Embinha/fechadura-eletronica-rfid/docs/evidencias/02 - Modulo rele SRD-05VDC.jpeg

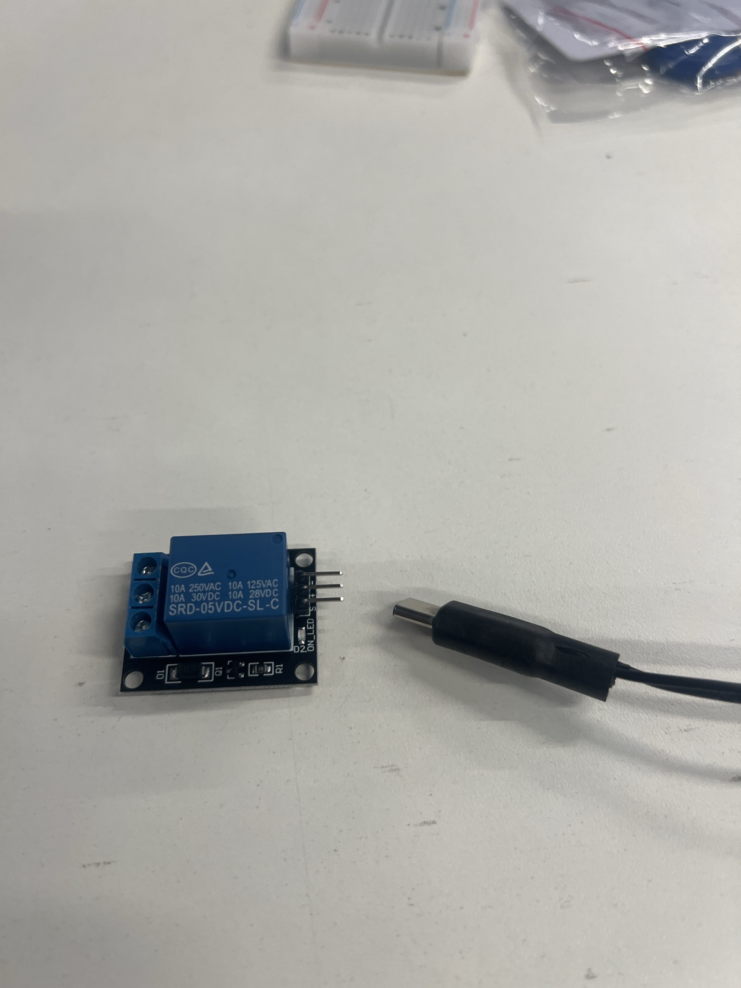
docs/evidencias/02 - Modulo rele SRD-05VDC.jpeg
