Embinha/fechadura-eletronica-rfid/docs/evidencias/03 - Fechadura solenoide.jpg

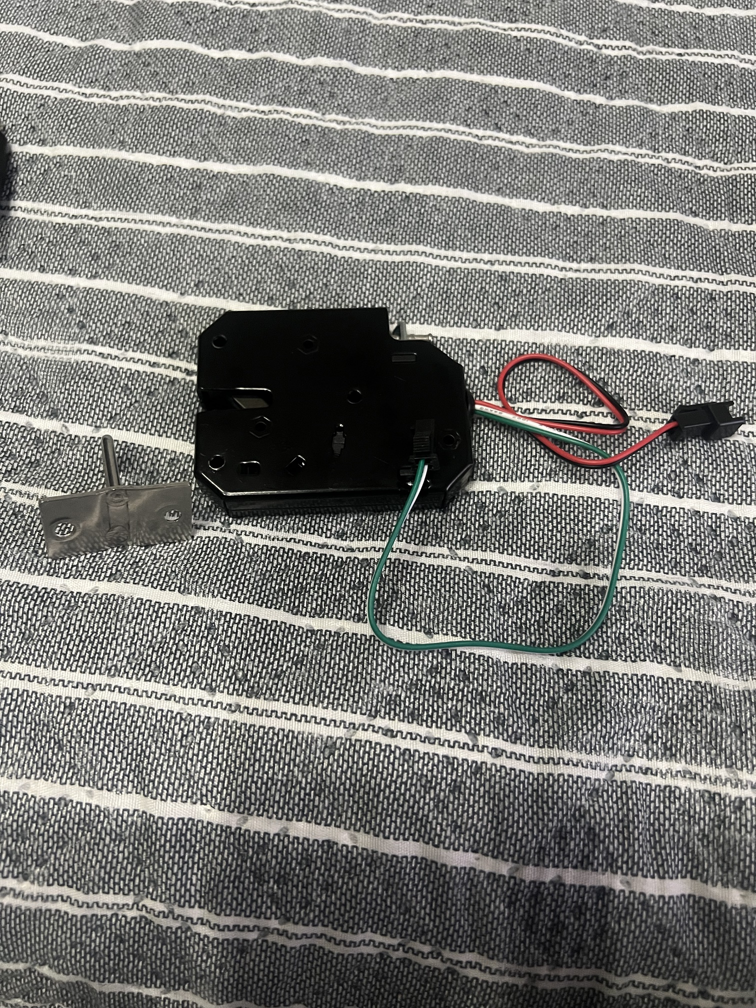
docs/evidencias/03 - Fechadura solenoide.jpg
