Embinha/fechadura-eletronica-rfid/docs/evidencias/04 - Fonte 12V 2A etiqueta.jpg

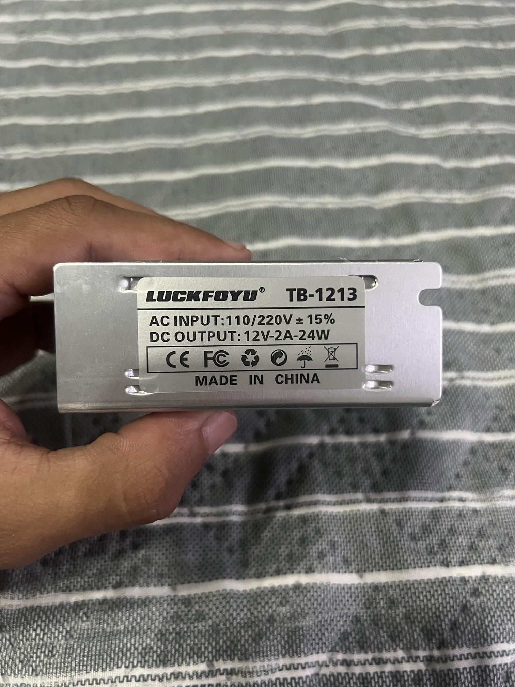
docs/evidencias/04 - Fonte 12V 2A etiqueta.jpg
