Embinha/fechadura-eletronica-rfid/docs/evidencias/05 - Ligacao do RC522 (pinos soldados).jpg

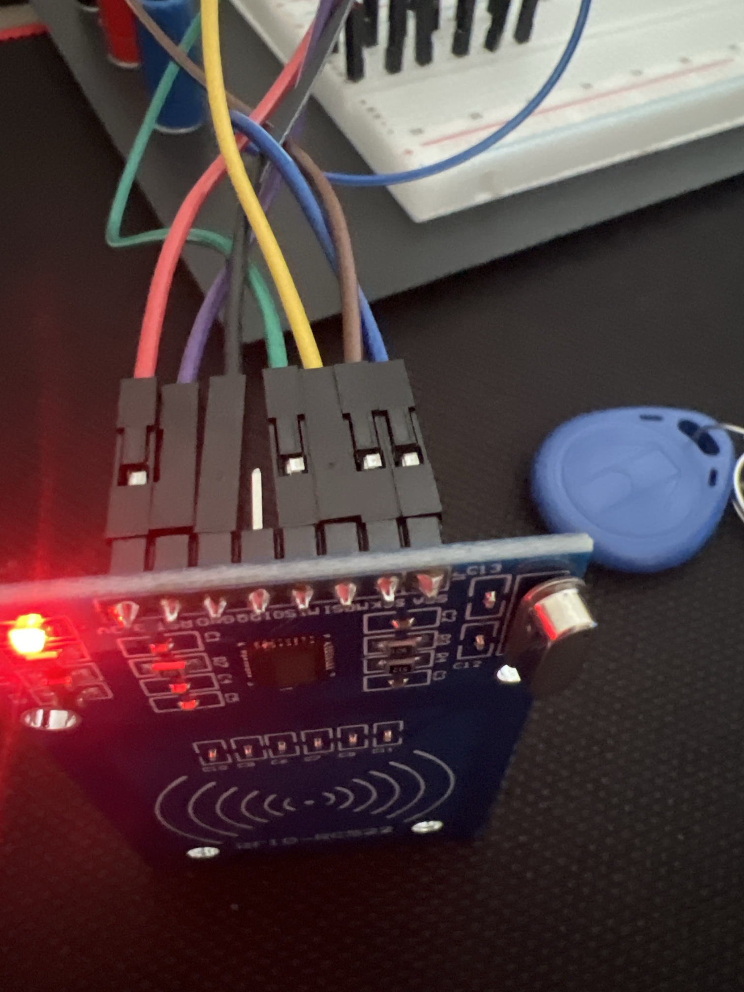
docs/evidencias/05 - Ligacao do RC522 (pinos soldados).jpg
