Embinha/fechadura-eletronica-rfid/docs/evidencias/07 - Upload do codigo no ESP32 concluido.png

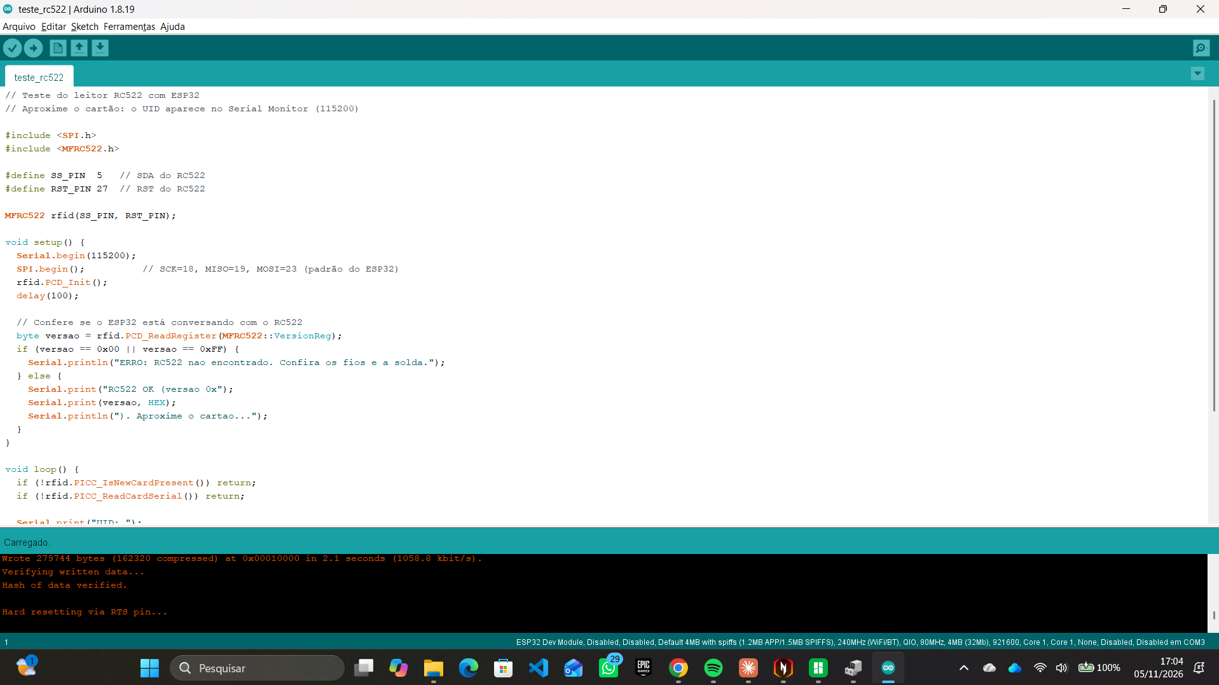
docs/evidencias/07 - Upload do codigo no ESP32 concluido.png
