Embinha/fechadura-eletronica-rfid/docs/evidencias/08 - RC522 comunicando com ESP32 (versao 0x92).png

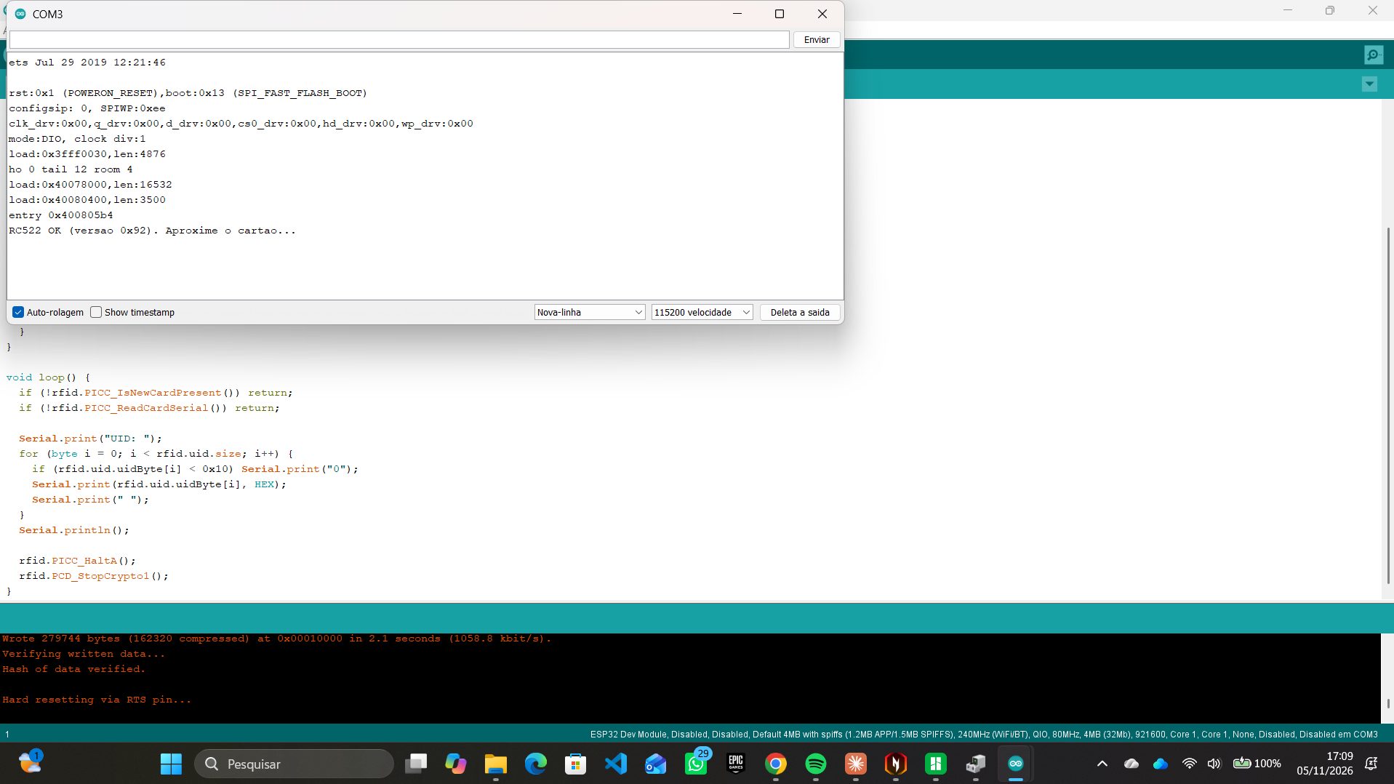
docs/evidencias/08 - RC522 comunicando com ESP32 (versao 0x92).png
