Embinha/fechadura-eletronica-rfid/docs/evidencias/09 - Diagnostico RC522 - autoteste falhou.png

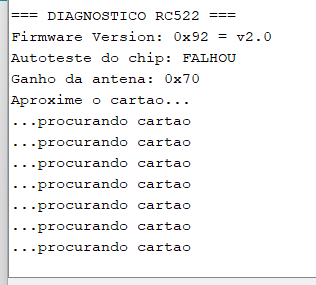
docs/evidencias/09 - Diagnostico RC522 - autoteste falhou.png
