Embinha/fechadura-eletronica-rfid/docs/evidencias/11 - Diagnostico com fio curto - autoteste falhou.png

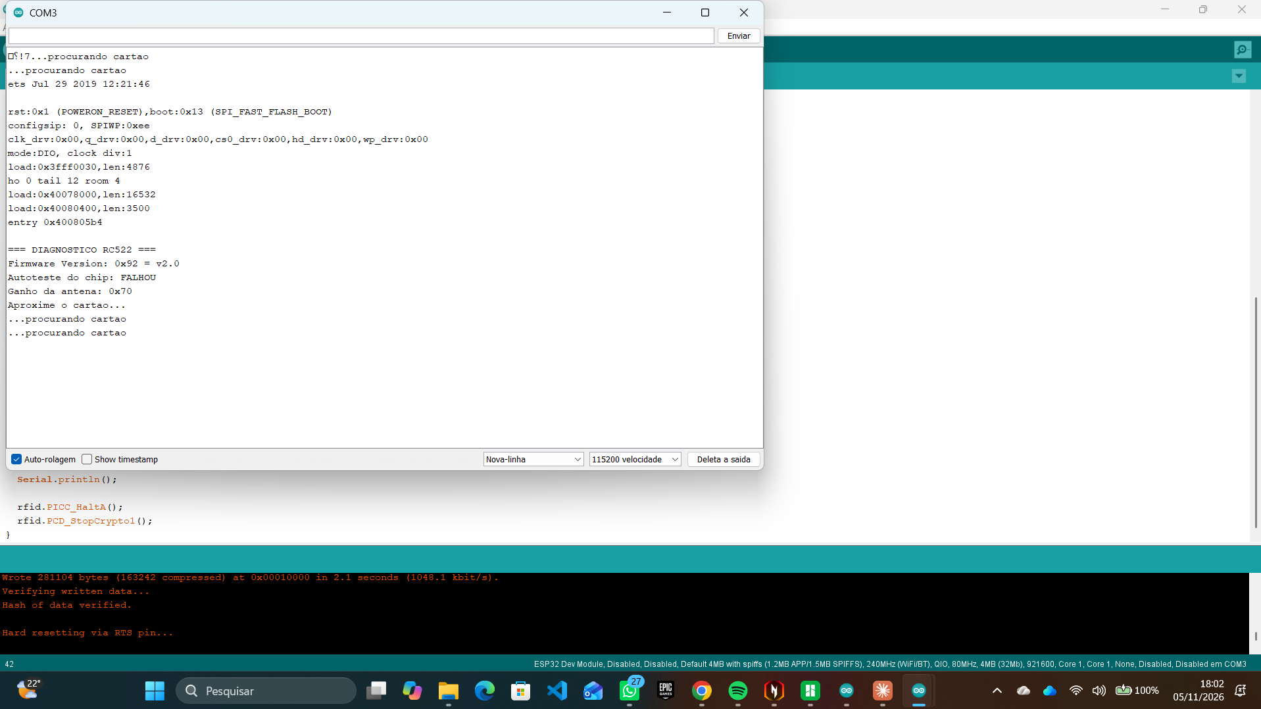
docs/evidencias/11 - Diagnostico com fio curto - autoteste falhou.png
