Embinha/fechadura-eletronica-rfid/docs/evidencias/12 - Cartao detectado mas falha ao ler UID.jpg

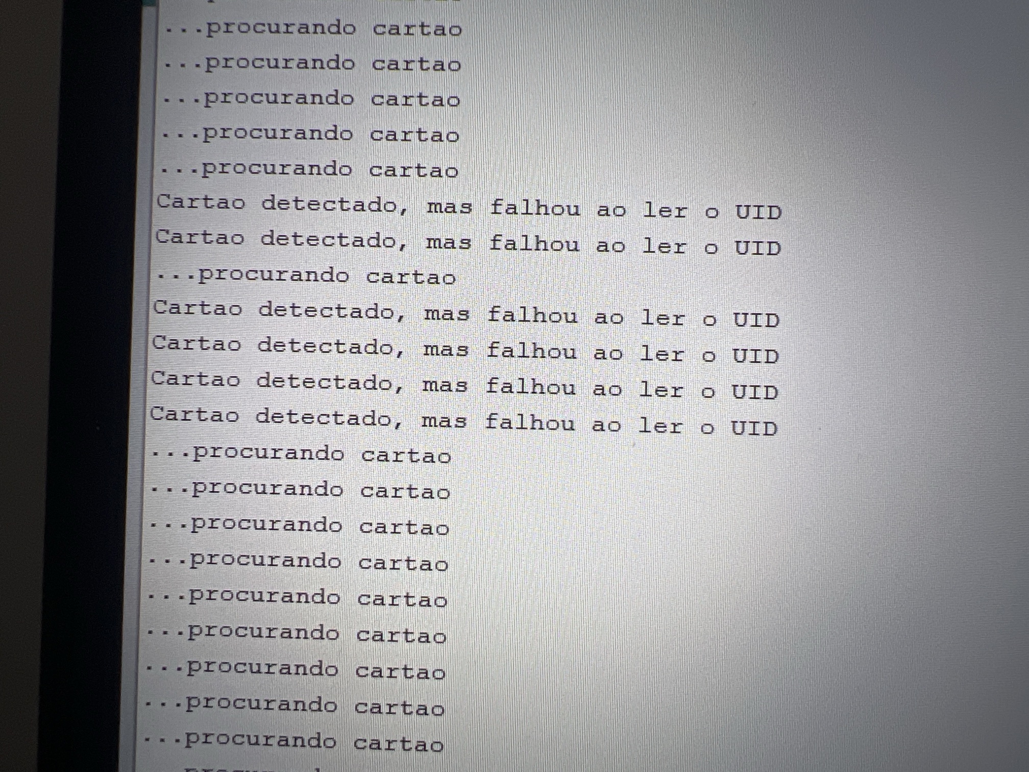
docs/evidencias/12 - Cartao detectado mas falha ao ler UID.jpg
