Embinha/fechadura-eletronica-rfid/docs/evidencias/15 - Abertura remota pelo navegador (log LIBERADO).png

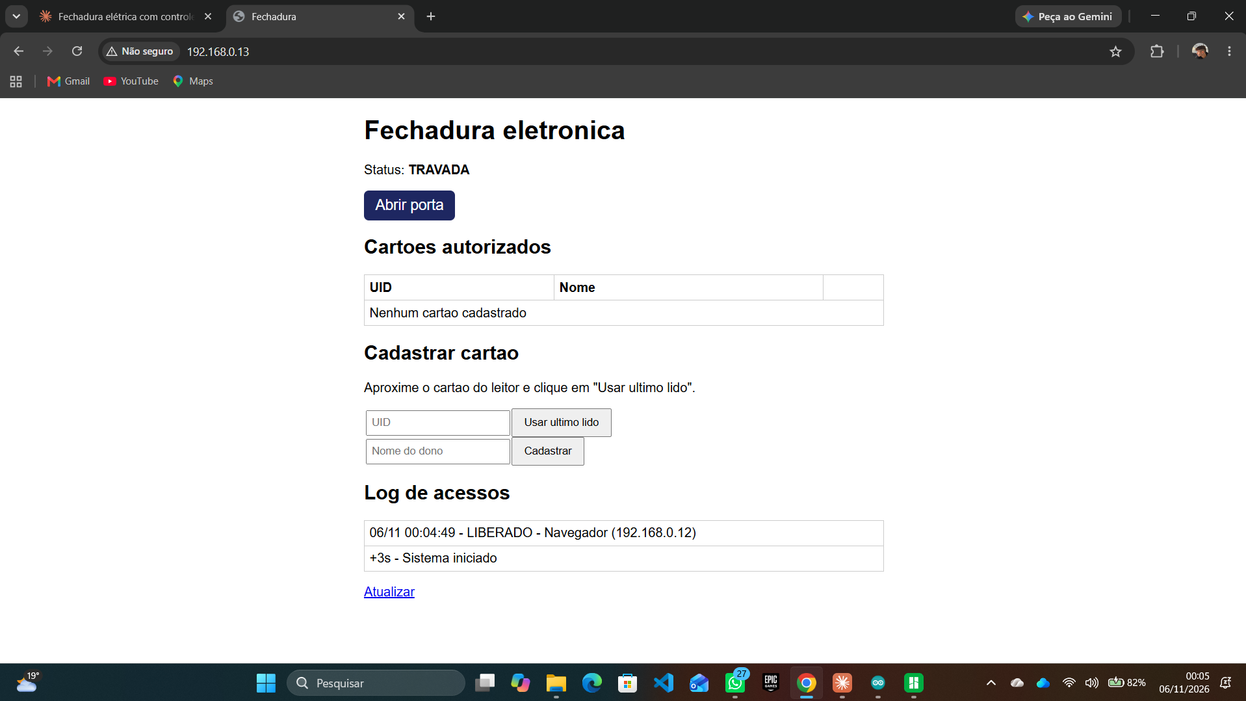
docs/evidencias/15 - Abertura remota pelo navegador (log LIBERADO).png
