Embinha/fechadura-eletronica-rfid/docs/evidencias/17 - Cartao cadastrado e log de acessos.png

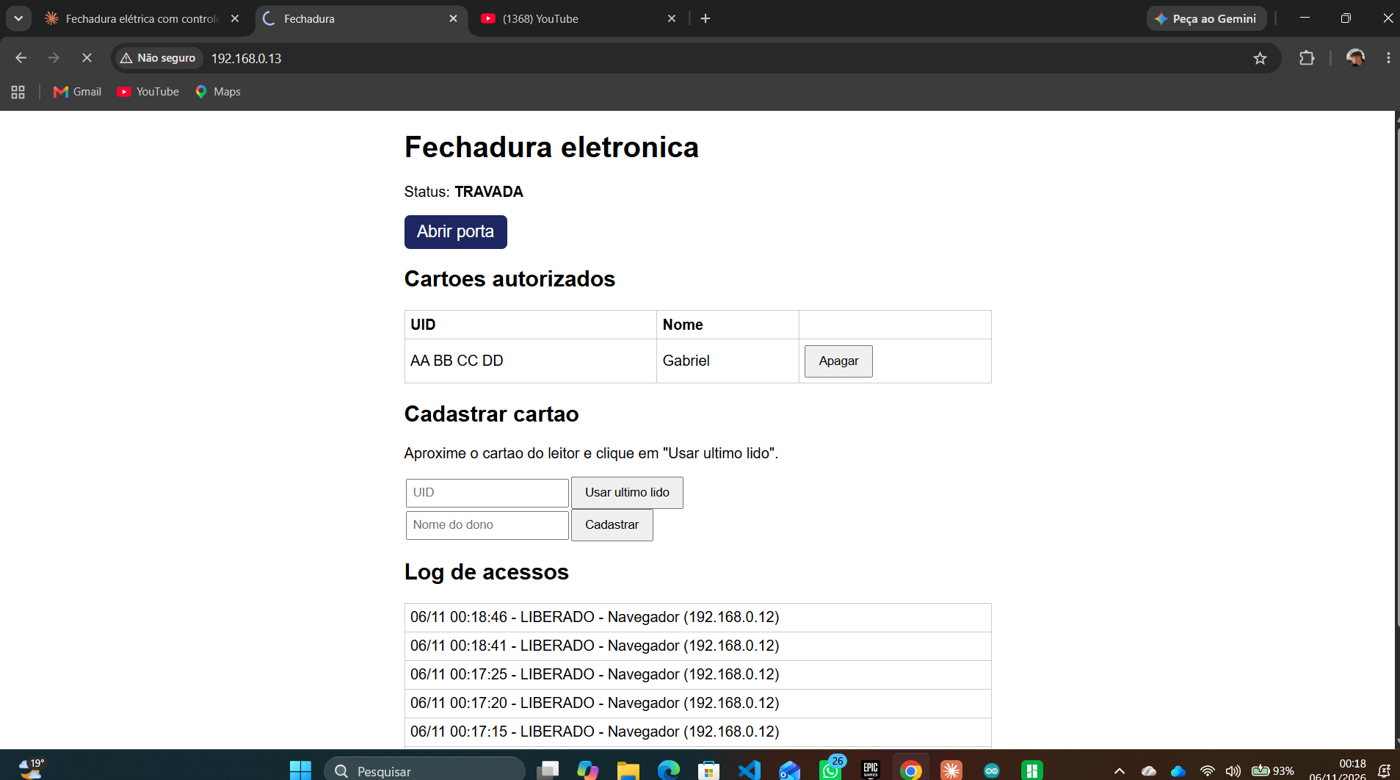
docs/evidencias/17 - Cartao cadastrado e log de acessos.png
