Embinha/fechadura-eletronica-rfid/docs/evidencias/18 - RC522 lendo UID de cartao e chaveiro.png

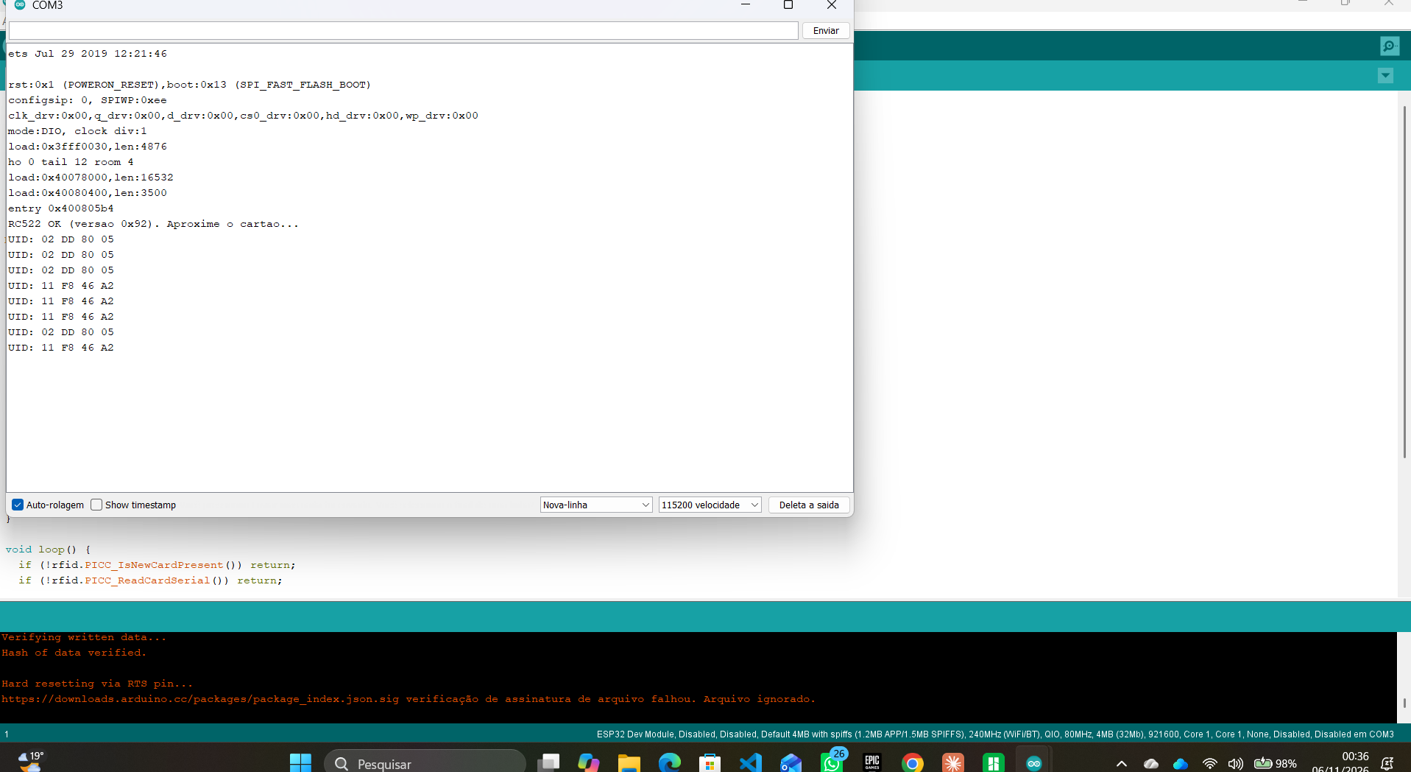
docs/evidencias/18 - RC522 lendo UID de cartao e chaveiro.png
