Embinha/fechadura-eletronica-rfid/docs/evidencias/21 - Log com LOGIN RECUSADO apos senha errada.png

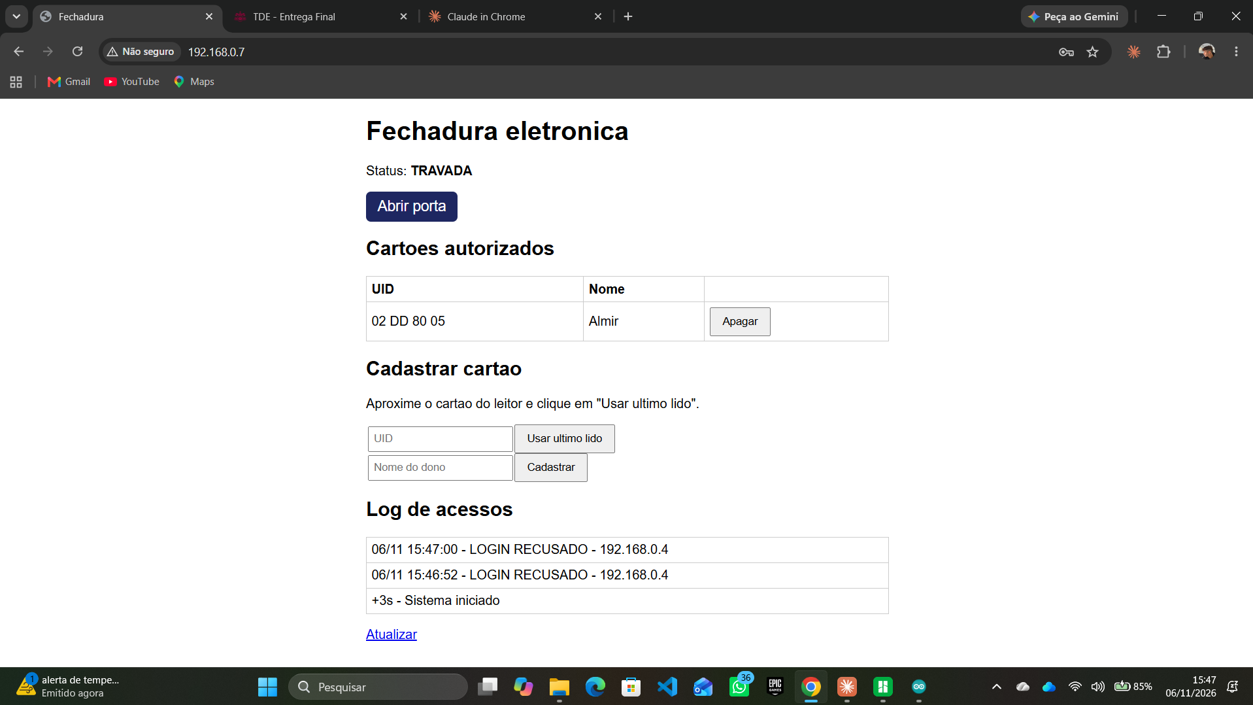
docs/evidencias/21 - Log com LOGIN RECUSADO apos senha errada.png
