Embinha/fechadura-eletronica-rfid/docs/evidencias/23 - Fechadura com o pino travado (sem energia).jpg

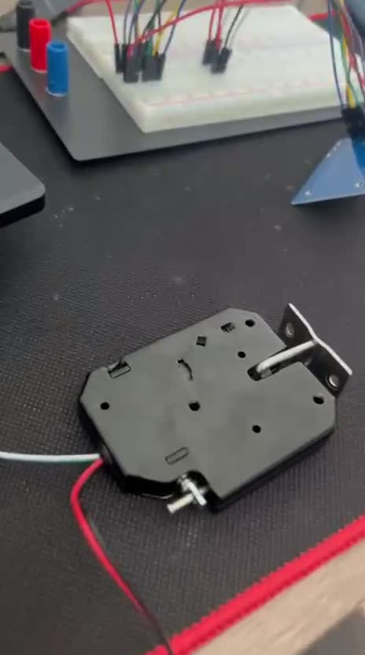
docs/evidencias/23 - Fechadura com o pino travado (sem energia).jpg
