Embinha/fechadura-eletronica-rfid/docs/maquete_3d/render_costas.png

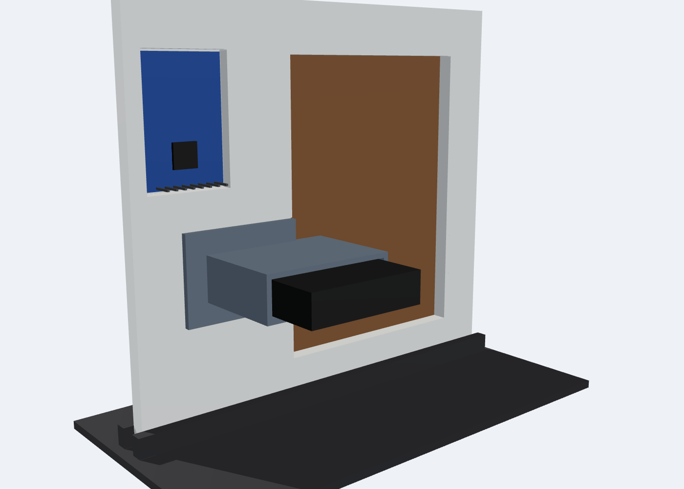
docs/maquete_3d/render_costas.png
