Embinha/fechadura-eletronica-rfid/docs/maquete_3d/render_frente.png

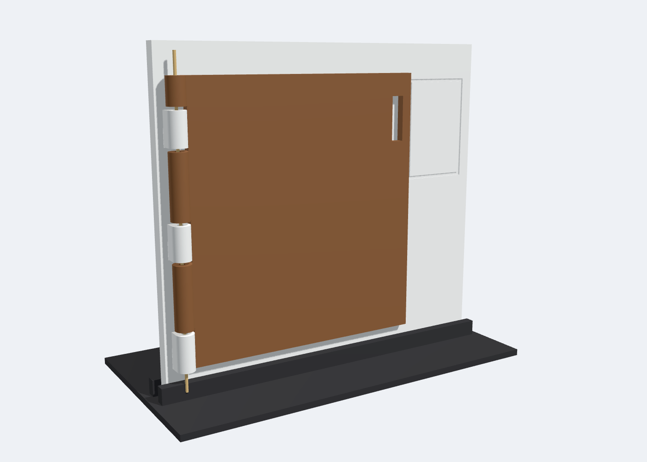
docs/maquete_3d/render_frente.png
