Embinha/fechadura-eletronica-rfid/docs/maquete_3d/4_suporte_fechadura.stl

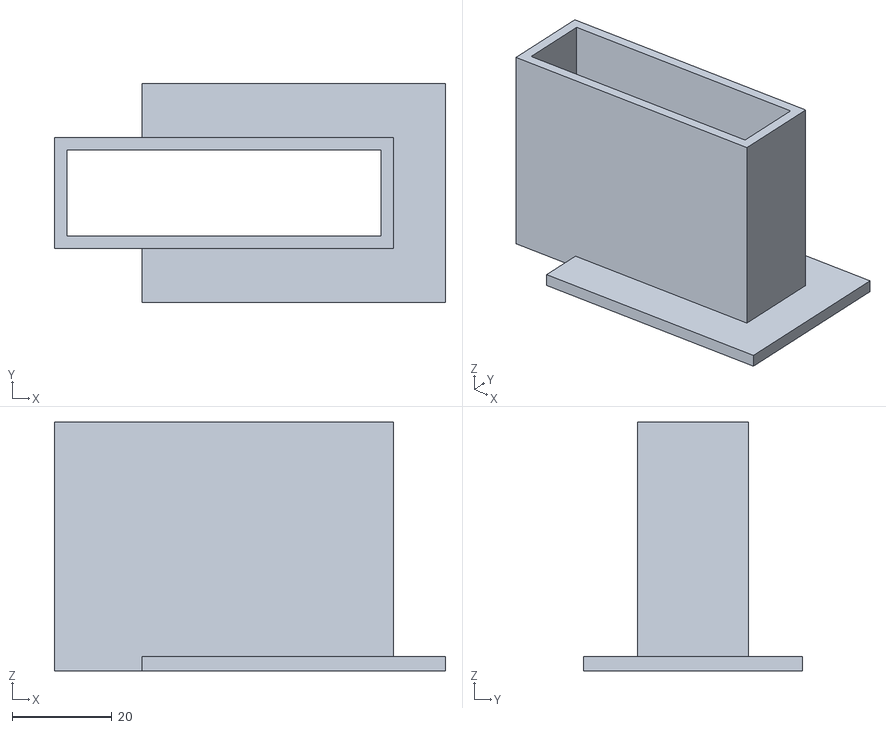
[picture p40: CAD file, 2026-11-09]
docs/maquete_3d/4_suporte_fechadura.stl
78.6 x 44.0 x 50.0
