Embinha/fechadura-eletronica-rfid/docs/maquete_3d/1_base.stl

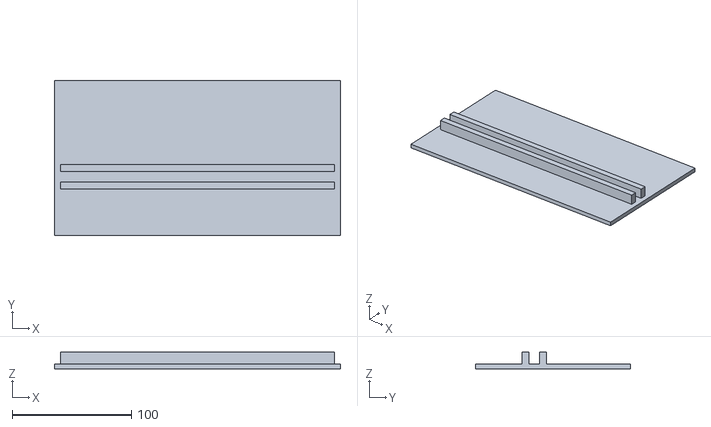
[picture p41: CAD file, 2026-11-09]
docs/maquete_3d/1_base.stl
240.0 x 130.0 x 14.0
