Embinha/fechadura-eletronica-rfid/docs/maquete_3d/3_porta.stl

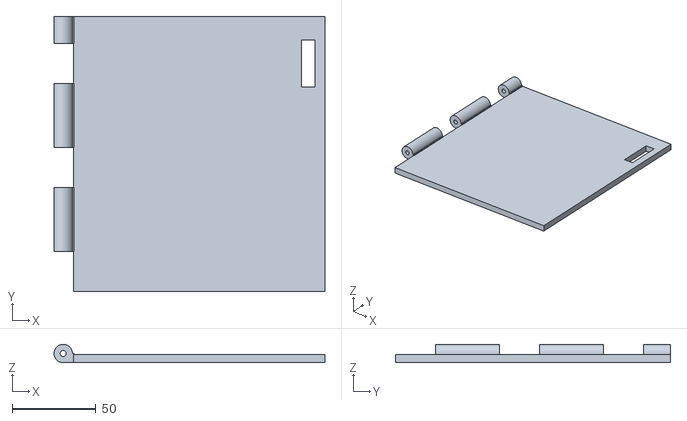
[picture p42: CAD file, 2026-11-09]
docs/maquete_3d/3_porta.stl
161.5 x 164.0 x 11.0
