Embinha/fechadura-eletronica-rfid/docs/maquete_3d/2_parede.stl

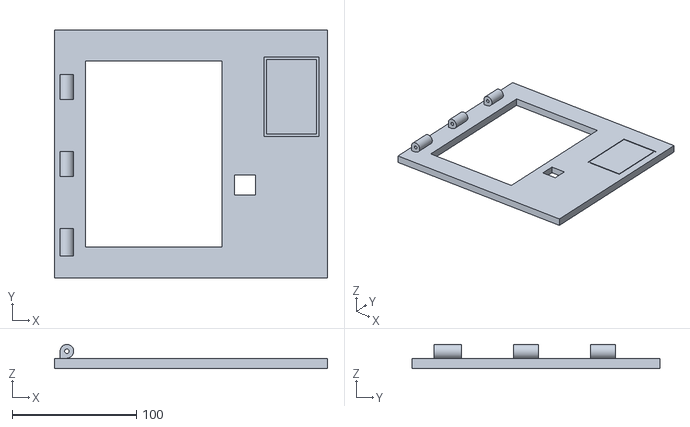
[picture p43: CAD file, 2026-11-09]
docs/maquete_3d/2_parede.stl
220.0 x 200.0 x 19.5
