Embinha/fechadura-eletronica-rfid/docs/maquete_3d/5_pino_dobradica.stl

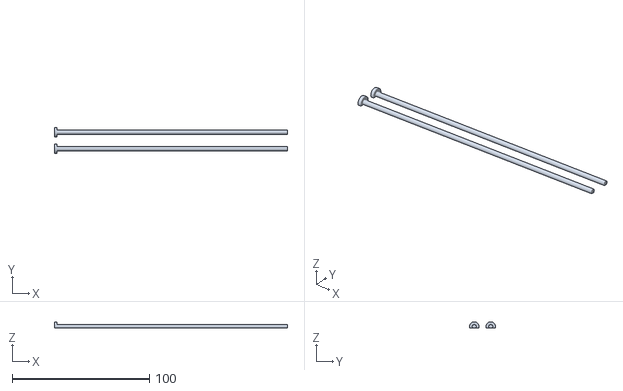
[picture p44: CAD file, 2026-11-09]
docs/maquete_3d/5_pino_dobradica.stl
170.0 x 19.0 x 4.70
