Embinha/fechadura-eletronica-rfid/docs/evidencias/10 - RC522 direto na protoboard (teste fio curto).jpg

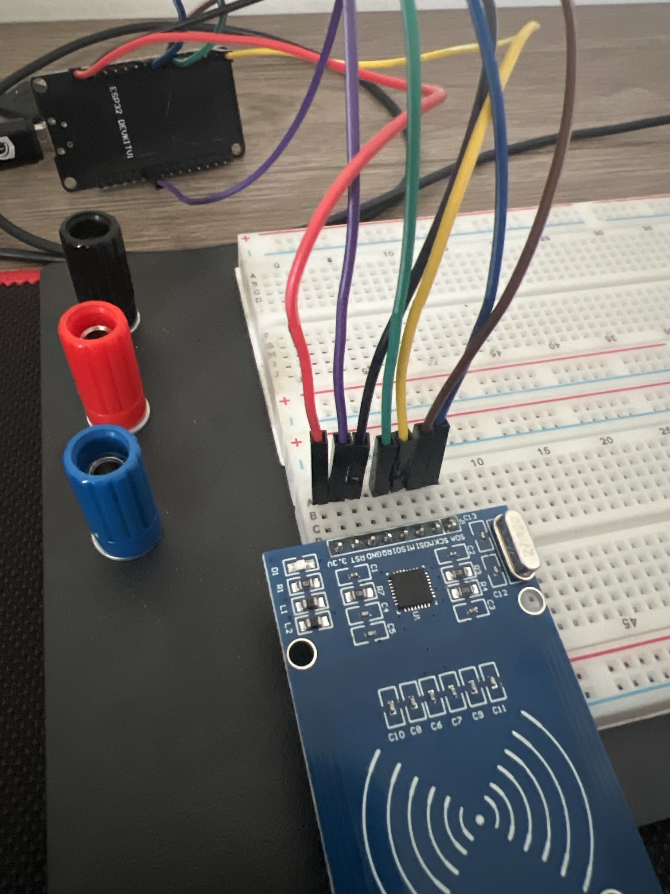
docs/evidencias/10 - RC522 direto na protoboard (teste fio curto).jpg
