Embinha/fechadura-eletronica-rfid/docs/evidencias/13 - Codigo de teste do rele compilado.png

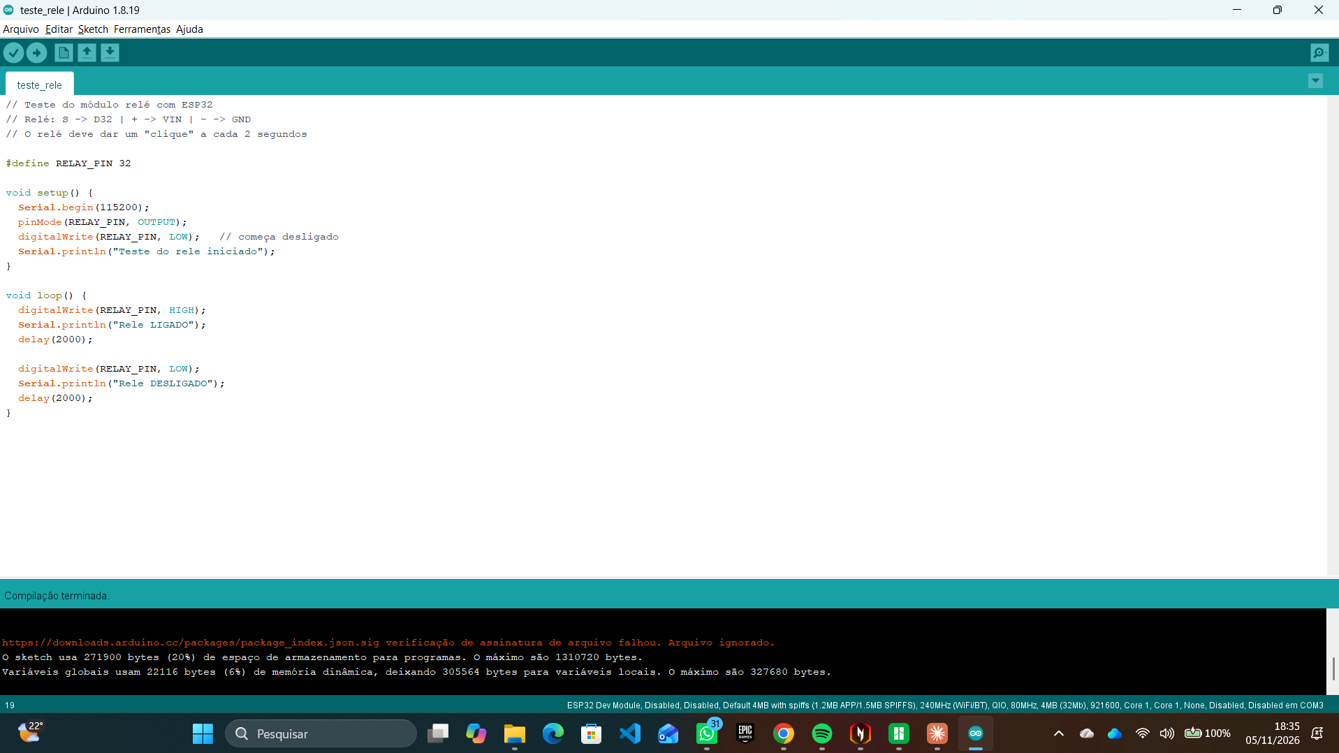
docs/evidencias/13 - Codigo de teste do rele compilado.png
