Embinha/fechadura-eletronica-rfid/(commit log)

2026-11-09 Versao final projeto
    [1_base.stl, 2_parede.stl, 3_porta.stl, 4_suporte_fechadura.stl, 5_pino_dobradica.stl]
2026-11-10 docs: adiciona seção de contribuições
2026-11-10 adiciona contribuição de Rodolfo
2026-11-10 adiciona contribuição de Kauan
2026-11-11 docs: adiciona contribuição de Gabriel Lucena
2026-11-11 docs: adiciona contribuição de Eduardo
